ProgrammingRobotsStudyGroup/Designs-And-Notes/designs/12cm_chassis/top.pdf

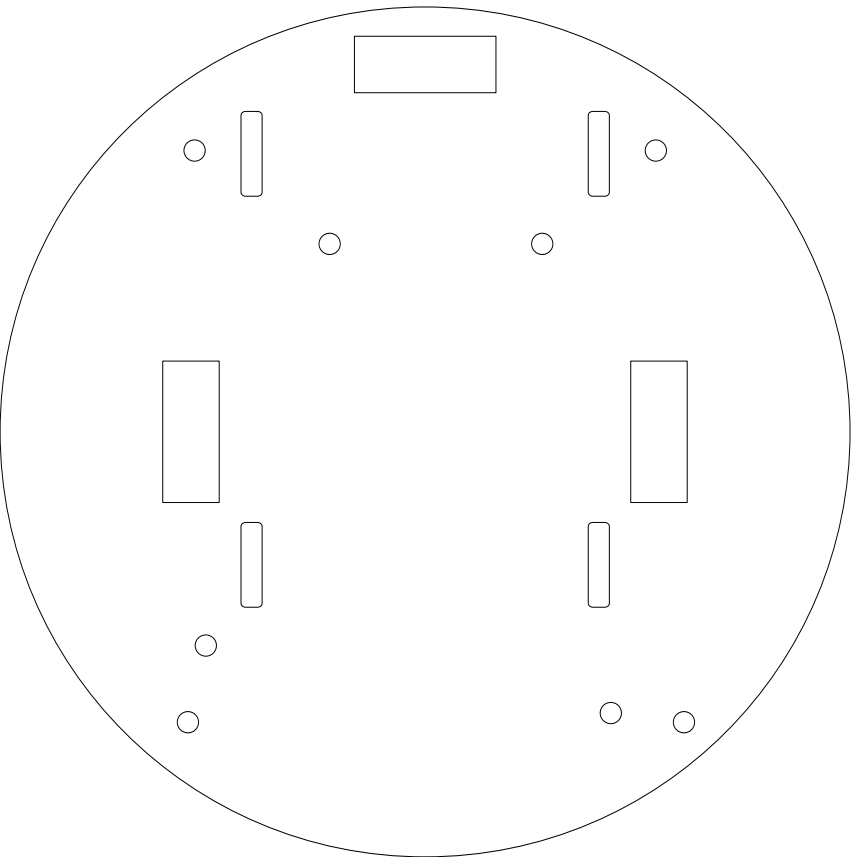
[picture p3: figure]
