ProgrammingRobotsStudyGroup/Designs-And-Notes/Data Sheets/Allegro/0J3580.1200.jpg

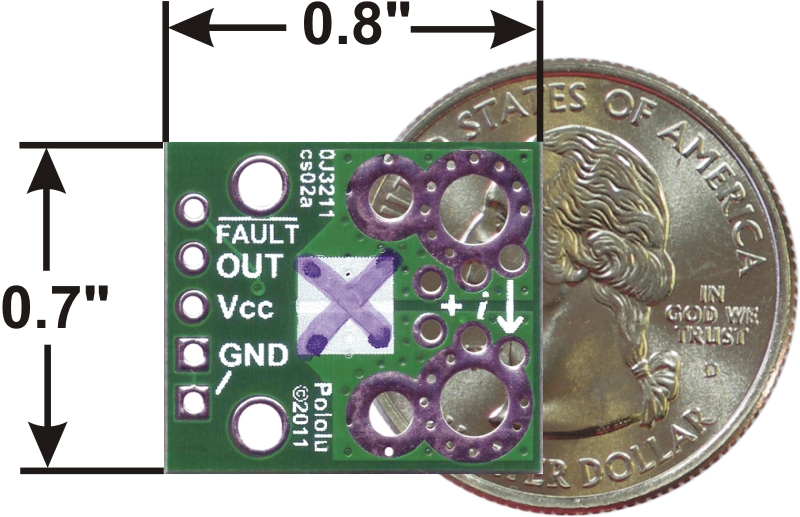
Data Sheets/Allegro/0J3580.1200.jpg
