ProgrammingRobotsStudyGroup/Designs-And-Notes/Data Sheets/Allegro/0J3586.1200.jpg

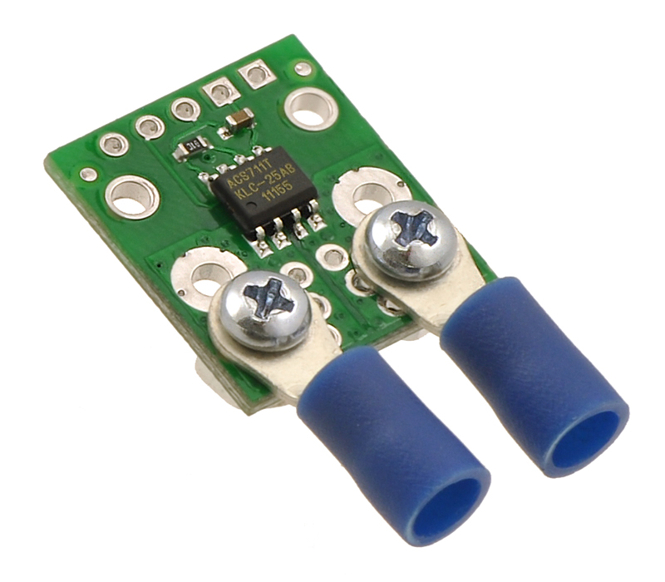
Data Sheets/Allegro/0J3586.1200.jpg
