ProgrammingRobotsStudyGroup/Designs-And-Notes/Data Sheets/Allegro/0J3588.1200.jpg

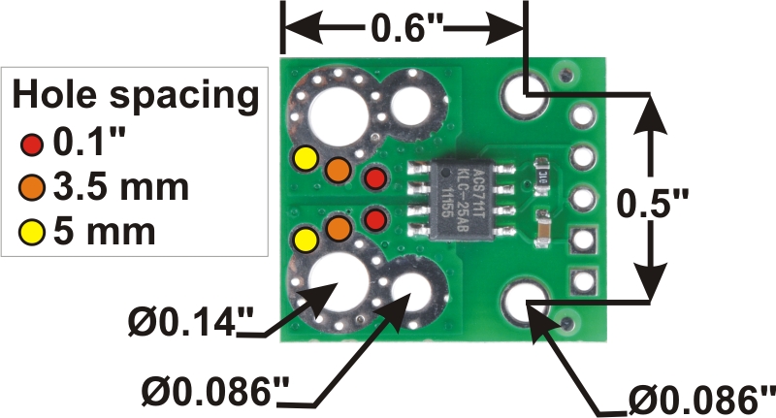
Data Sheets/Allegro/0J3588.1200.jpg
