ProgrammingRobotsStudyGroup/Designs-And-Notes/Data Sheets/Allegro/ACS711 schematic dia.png

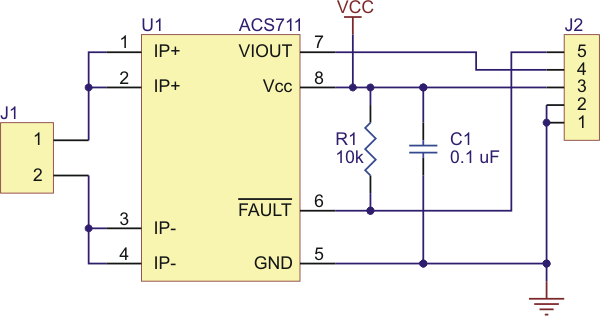
Data Sheets/Allegro/ACS711 schematic dia.png
