ProgrammingRobotsStudyGroup/Designs-And-Notes/Data Sheets/Pololu/60×8mm wheel with tire removed.jpg

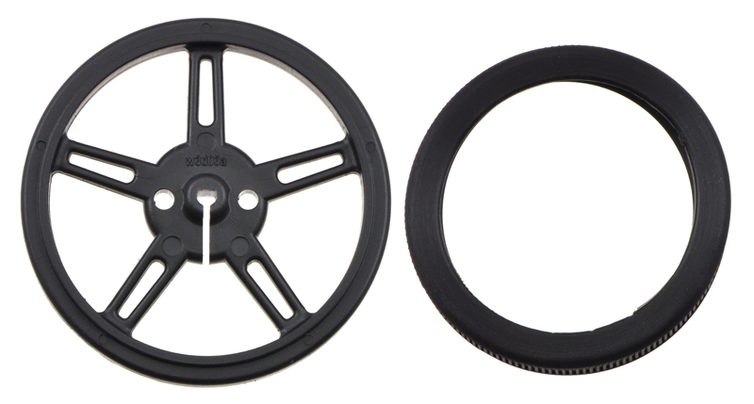
Data Sheets/Pololu/60×8mm wheel with tire removed.jpg
