ProgrammingRobotsStudyGroup/Designs-And-Notes/Data Sheets/Pololu/Mechanical drawing of Pololu wheel 60×8mm without tire..jpg

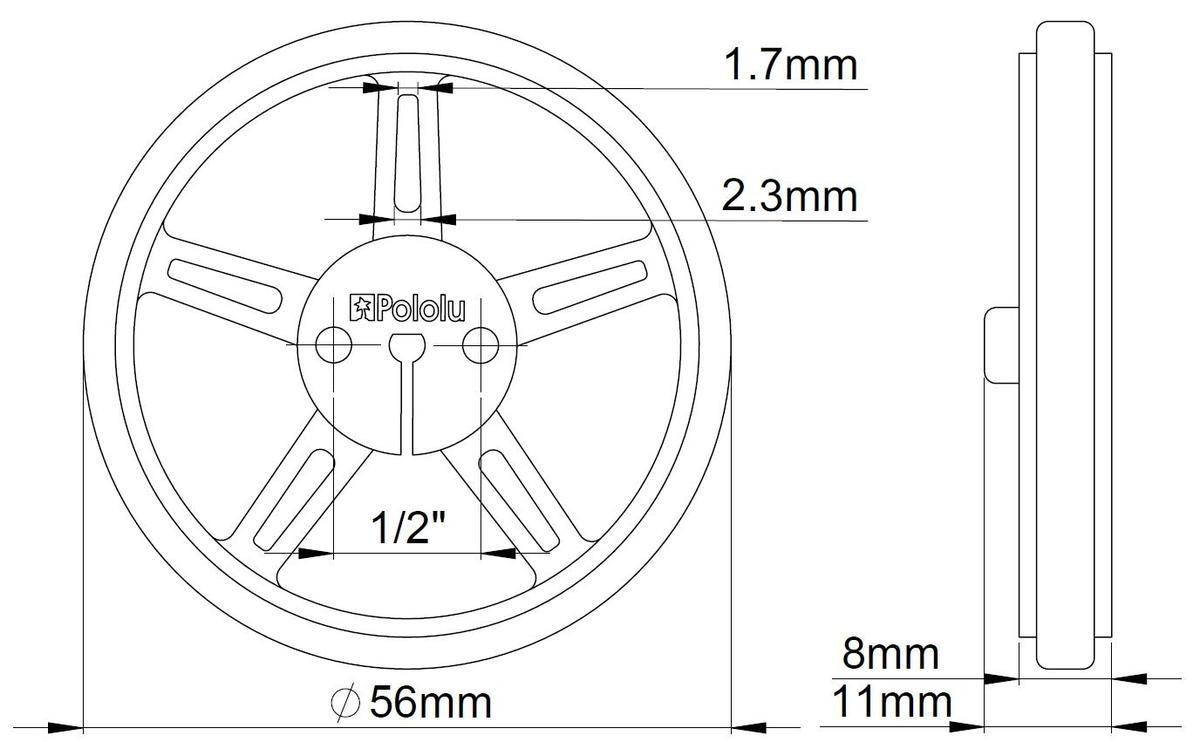
Data Sheets/Pololu/Mechanical drawing of Pololu wheel 60×8mm without tire..jpg
