ProgrammingRobotsStudyGroup/Designs-And-Notes/Data Sheets/Pololu/Pololu wheel 60×8mm – blue.jpg

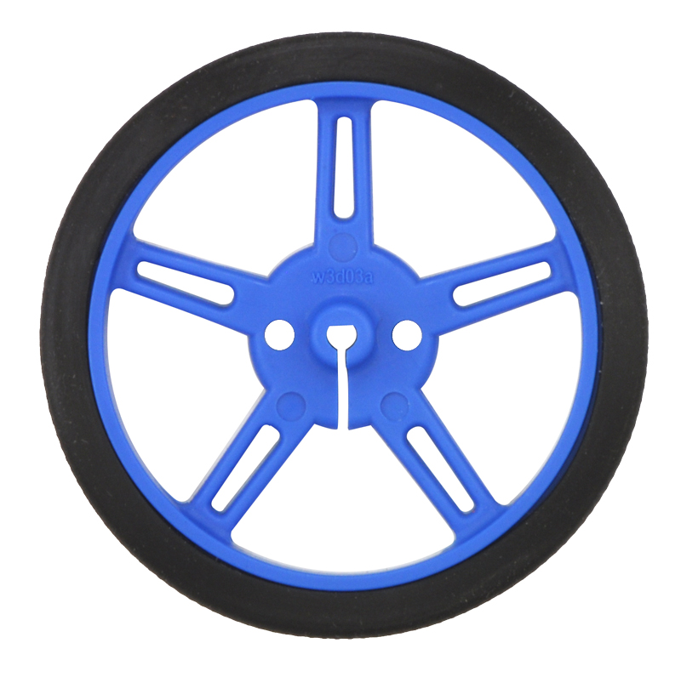
Data Sheets/Pololu/Pololu wheel 60×8mm – blue.jpg
