ProgrammingRobotsStudyGroup/Designs-And-Notes/how-to/images-assembly/a_star_bridge_pinout_dia.png

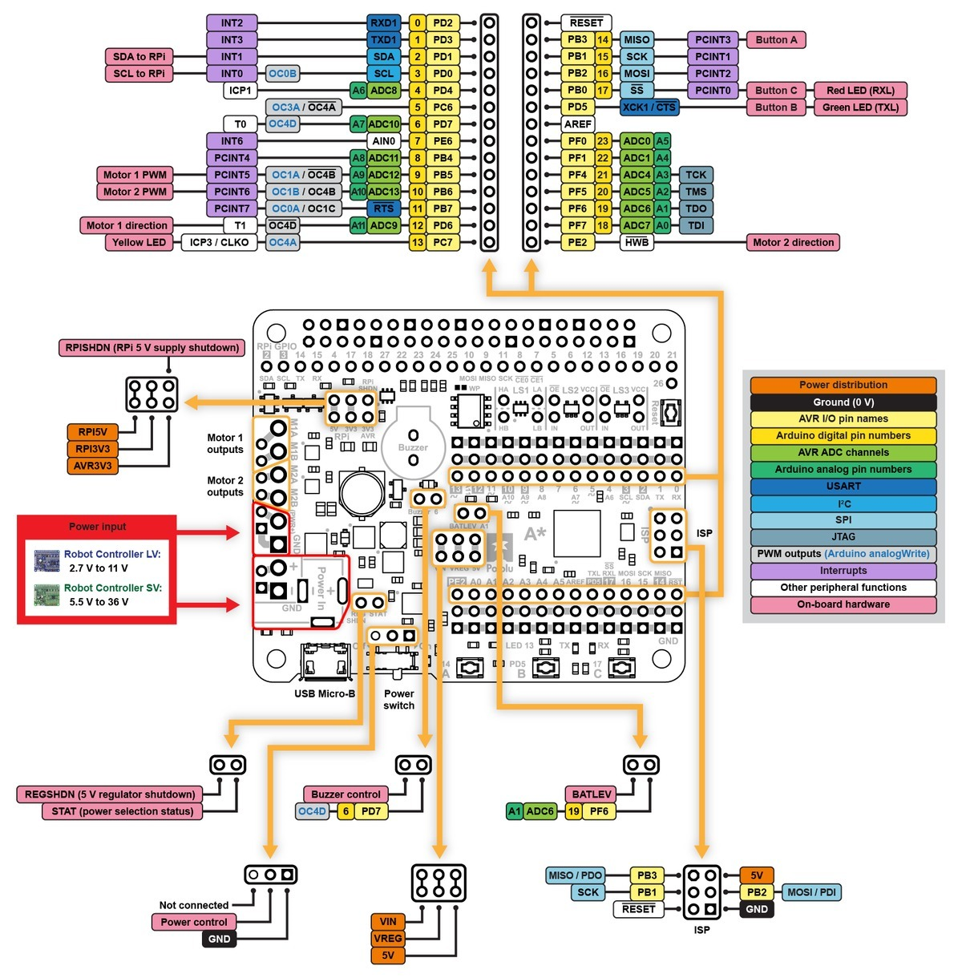
how-to/images-assembly/a_star_bridge_pinout_dia.png
