ProgrammingRobotsStudyGroup/Designs-And-Notes/images/3r2/9in base level a v13.jpg

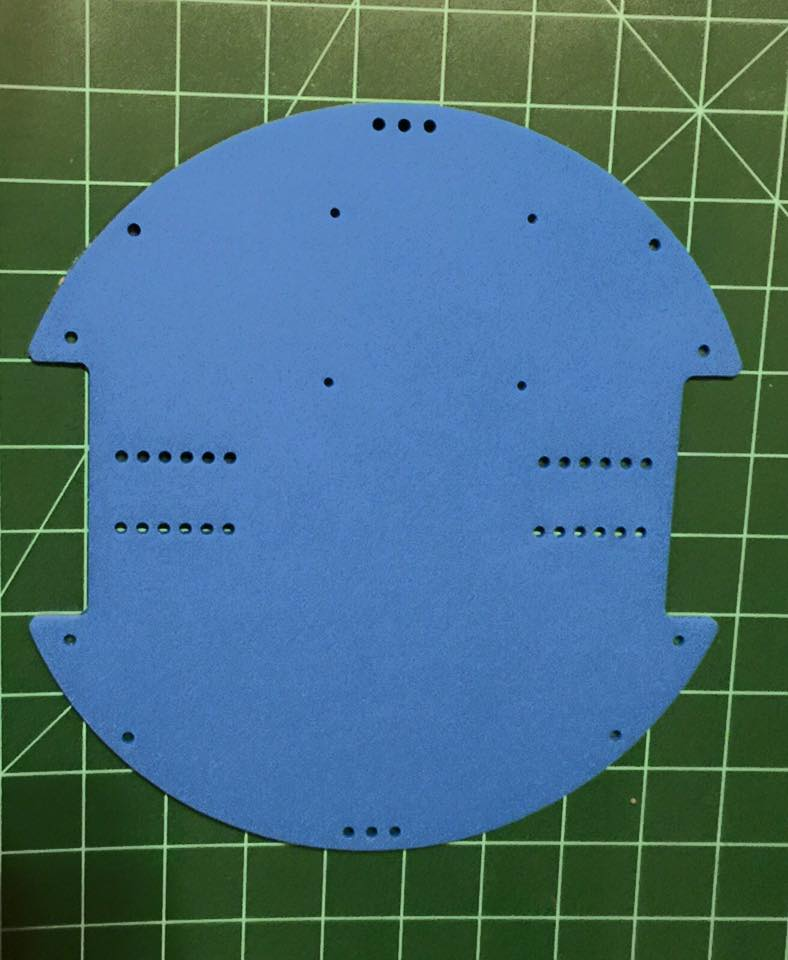
images/3r2/9in base level a v13.jpg
