ProgrammingRobotsStudyGroup/Designs-And-Notes/images/3r2/20160118_205052360_iOS.jpg

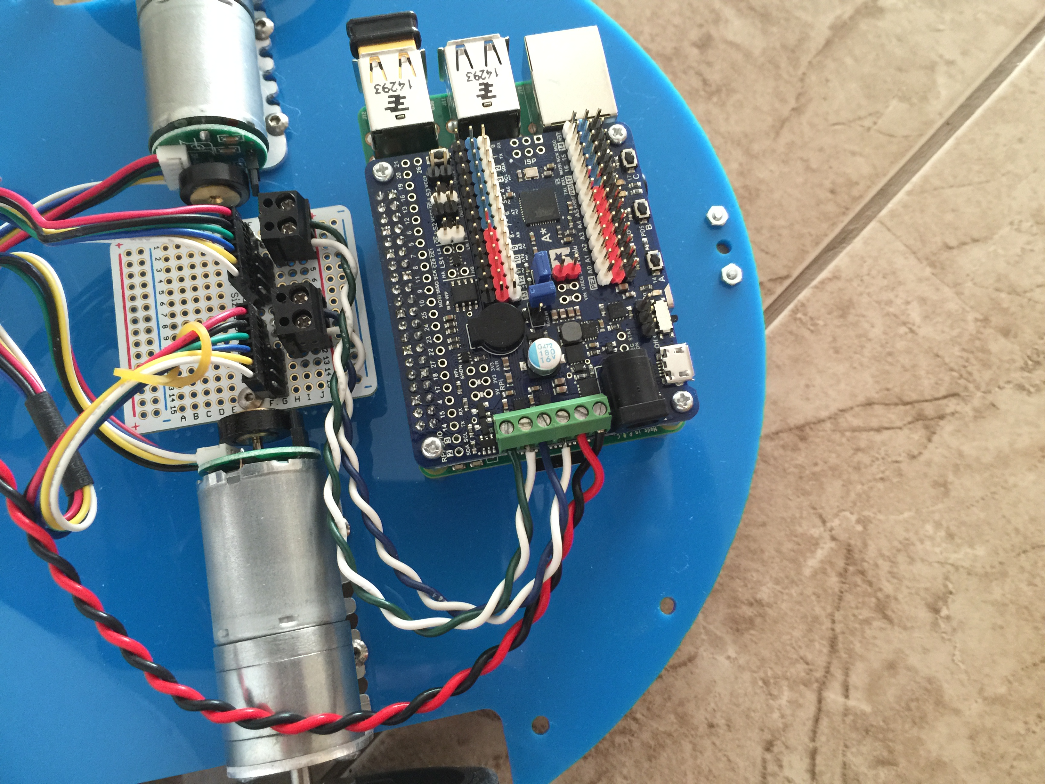
images/3r2/20160118_205052360_iOS.jpg
