ProgrammingRobotsStudyGroup/Designs-And-Notes/images/3r2/base with motor and pi plus a star.jpg

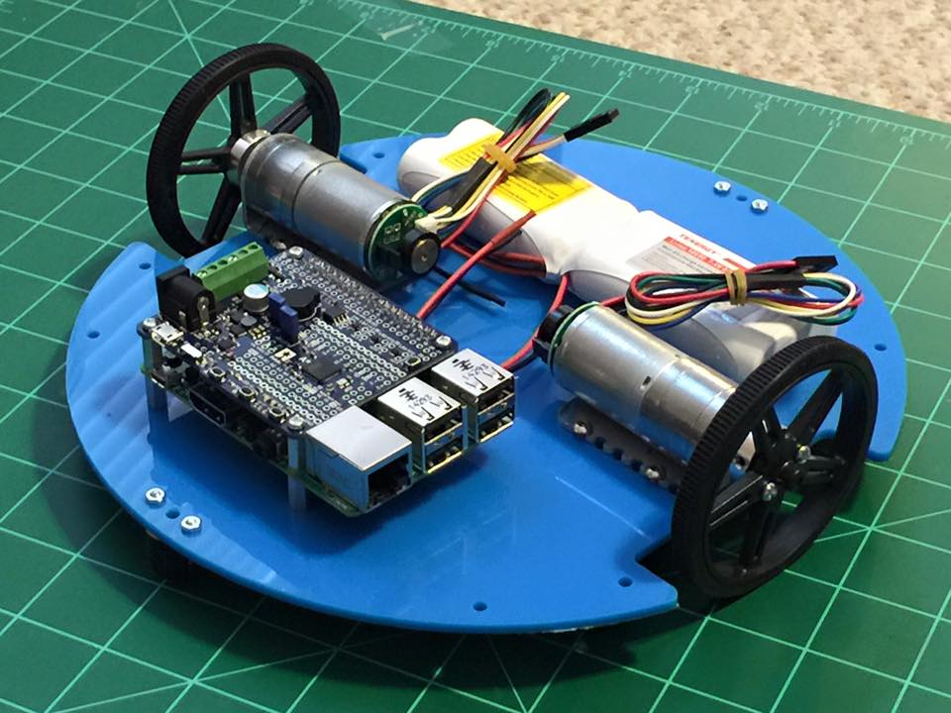
images/3r2/base with motor and pi plus a star.jpg
