ProgrammingRobotsStudyGroup/Designs-And-Notes/images/3r2/base with motors.jpg

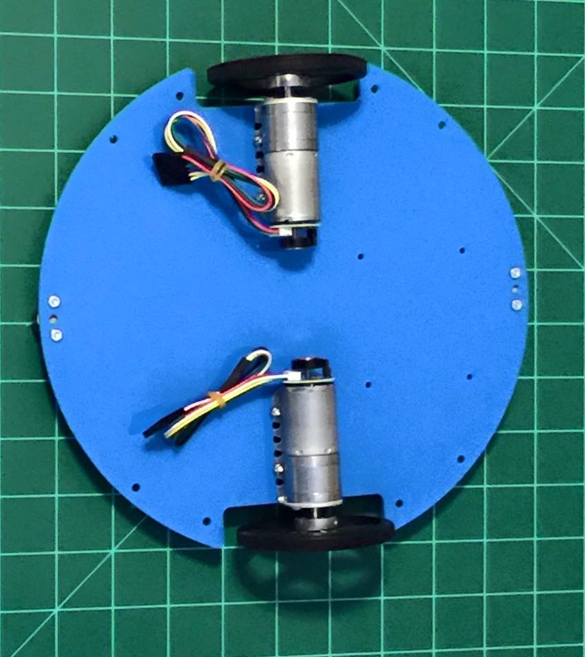
images/3r2/base with motors.jpg
