ProgrammingRobotsStudyGroup/Designs-And-Notes/images/Encoder_XOR.png

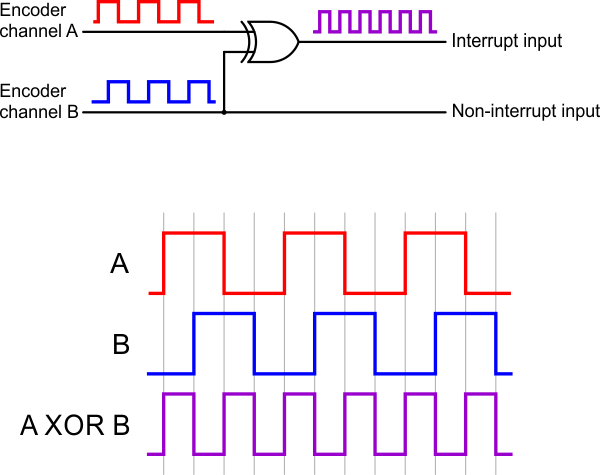
images/Encoder_XOR.png
