ProgrammingRobotsStudyGroup/Designs-And-Notes/Worksheets/pololu motor plot.png

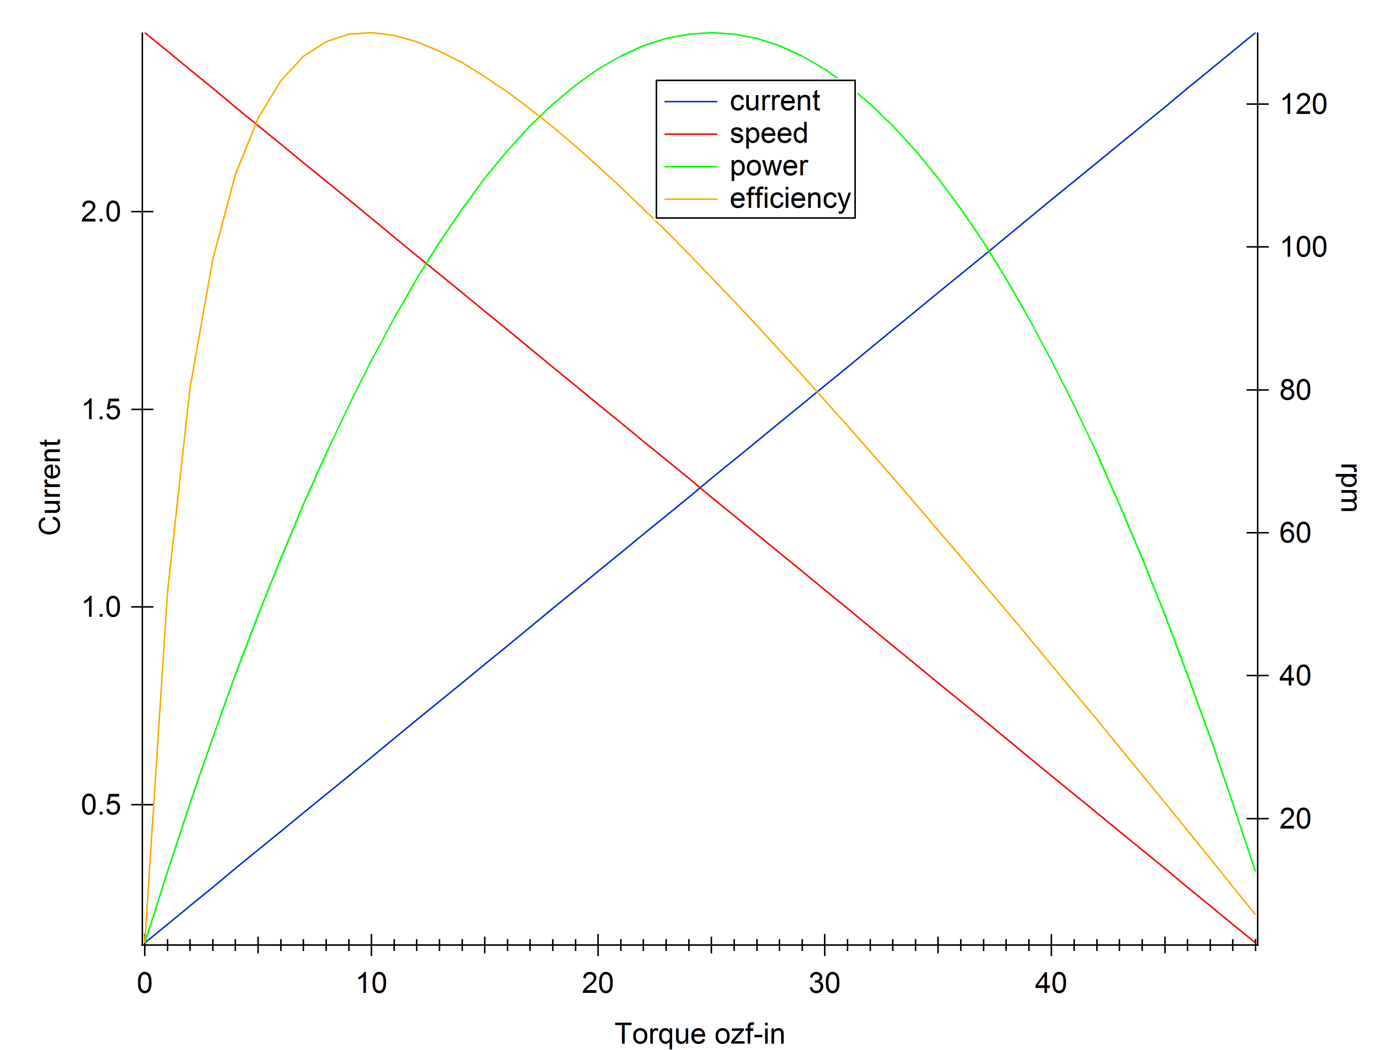
Worksheets/pololu motor plot.png
