ProgrammingRobotsStudyGroup/Designs-And-Notes/Worksheets/ROS ROV REV 2.xlsx

Sheet: Wheels
Wheel Size |  | Motor Speed |  | Motor Speed |  | Motor Speed |  | Motor Speed |  | Motor Speed |  | Motor Speed
 |  | 50 |  | 90 |  | 100 |  | 130 |  | 200 |  | 320
inches | mm | in/sec | m/sec | in/sec | m/sec | in/sec | m/sec | in/sec | m/sec | in/sec | m/sec | in/sec | m/sec
1.26 | 32 | 3.30 | 0.08 | 5.94 | 0.15 | 6.60 | 0.17 | 8.58 | 0.22 | 13.19 | 0.34 | 21.11 | 0.54
1.57 | 40 | 4.12 | 0.10 | 7.42 | 0.19 | 8.25 | 0.21 | 10.72 | 0.27 | 16.49 | 0.42 | 26.39 | 0.67
1.65 | 42 | 4.33 | 0.11 | 7.79 | 0.20 | 8.66 | 0.22 | 11.26 | 0.29 | 17.32 | 0.44 | 27.71 | 0.70
1.97 | 50 | 5.15 | 0.13 | 9.28 | 0.24 | 10.31 | 0.26 | 13.40 | 0.34 | 20.61 | 0.52 | 32.98 | 0.84
2.36 | 60 | 6.18 | 0.16 | 11.13 | 0.28 | 12.37 | 0.31 | 16.08 | 0.41 | 24.74 | 0.63 | 39.58 | 1.01
2.5 | 63.5 | 6.54 | 0.17 | 11.78 | 0.30 | 13.09 | 0.33 | 17.02 | 0.43 | 26.18 | 0.66 | 41.89 | 1.06
2.76 | 70 | 7.21 | 0.18 | 12.99 | 0.33 | 14.43 | 0.37 | 18.76 | 0.48 | 28.86 | 0.73 | 46.18 | 1.17
2.95 | 75 | 7.73 | 0.20 | 13.91 | 0.35 | 15.46 | 0.39 | 20.10 | 0.51 | 30.92 | 0.79 | 49.47 | 1.26
3.15 | 80 | 8.25 | 0.21 | 14.84 | 0.38 | 16.49 | 0.42 | 21.44 | 0.54 | 32.98 | 0.84 | 52.77 | 1.34
3.94 | 100 | 10.31 | 0.26 | 18.55 | 0.47 | 20.61 | 0.52 | 26.80 | 0.68 | 41.23 | 1.05 | 65.97 | 1.68
4.72 | 120 | 12.37 | 0.31 | 22.26 | 0.57 | 24.74 | 0.63 | 32.16 | 0.82 | 49.47 | 1.26 | 79.16 | 2.01

Sheet: Motor size sheet
 | Input
Total mass | 1.81 | Kg
Number of drive motors | 2 | #
Radius of drive wheel | 0.035 | m
Robot Velocity | 0.4 | ms
Maximum incline | 20 | deg
Supply voltage | 7.4 | V
Desired acceleration | 0.2 | m/s^2
Desired operating time | 120 | min
Total efficiency | 65 | %
 | Output
Angular Velocity | 11.43 | rad/s | 109.19 | rev/min
Torque | 0.17 | Nm | 1.77 | Kgf-cm | 24.53 | ozf-in
Total Power | 1.98 | W | 0.002655200576 | hp
Maximum current | 0.27 | A
Battery Pack | 1.07 | Ah
 | Mass(lb)
 | 1 | 2 | 3 | 4 | 5 | 10 | 20
 | Mass(Kg)
 | 0.45 | 0.91 | 1.36 | 1.81 | 2.27 | 4.54 | 9.07
Torque
Nm | 0.0434 | 0.09 | 0.13 | 0.17 | 0.22 | 0.43 | 0.87
Kgf-cm | 0.44 | 0.89 | 1.33 | 1.77 | 2.21 | 4.43 | 8.85
ozf-in | 6.15 | 12.29 | 18.44 | 24.59 | 30.74 | 61.47 | 122.95
Power
W | 0.50 | 0.99 | 1.49 | 1.98 | 2.48 | 4.96 | 9.92
A | 0.07 | 0.13 | 0.20 | 0.27 | 0.34 | 0.67 | 1.34
Ah | 0.27 | 0.54 | 0.80 | 1.07 | 1.34 | 2.68 | 5.36
 | Torque
Nm | 0.037 | 0.075 | 0.282 | 0.353 | 1.766 | 2.799 | 0.565
Kgf-cm | 0.379 | 0.760 | 2.880 | 3.600 | 17.998 | 28.532 | 5.759
ozf-in | 5.267 | 10.557 | 40.000 | 50.000 | 250.000 | 396.319 | 80.000
lbf-in |  |  |  |  |  | 24.780
Mass(Kg) | 0.3886440828 | 0.7789179634 | 2.951394937 | 3.689243671 | 18.44621835 | 29.24233301 | 5.902789873
Mass(lb) | 0.8568135368 | 1.717220163 | 6.506712043 | 8.133390054 | 40.66695027 | 64.46830886 | 13.01342409
 | Torque |  |  |  |  |  | Maker Block
Nm | 0.037 | 0.075 | 0.282 | 0.353 | 1.766 | 2.799 | 0.565
Kgf-cm | 0.379 | 0.760 | 2.880 | 3.600 | 17.998 | 28.532 | 5.759
ozf-in | 5.267 | 10.557 | 40.000 | 50.000 | 250.000 | 396.319 | 80.000
lbf-in |  |  |  |  |  | 24.780
Mass(Kg) | 0.3886440828 | 0.7789179634 | 2.951394937 | 3.689243671 | 18.44621835 | 29.24233301 | 5.902789873
Mass(lb) | 0.8568135368 | 1.717220163 | 6.506712043 | 8.133390054 | 40.66695027 | 64.46830886 | 13.01342409
Maker Block
Nm | 0.565
Kgf-cm | 5.759
ozf-in | 80.000
lbf-in
Mass(Kg) | 5.902789873
Mass(lb) | 13.01342409
Pololu
Nm | 0.353 |  | 0.177
Kgf-cm | 3.600 |  | 1.800
ozf-in | 50.000 |  | 25.000
lbf-in
Mass(Kg) | 3.689243671 |  | 1.844621835
Mass(lb) | 8.133390054 |  | 4.066695027
Mcpro
Nm | 2.799
Kgf-cm | 28.532
ozf-in | 396.319
lbf-in | 24.780
Mass(Kg) | 29.24233301
Mass(lb) | 64.46830886

Sheet: Parts List
BASE HARDWARE(MIN)
Item | QTY | Cost |  | source |  | Power V |  | Current |  | Weight
Raspberry Pi 2 | 1 | 35 | 35 |  |  | 5 | V | 0.8 | A
Wifi Adapter | 1 | 10 | 10 |  |  | 5 |  | 0.3 | A
BLE 4.0 Adapter | 1 | 10 | 10 |  |  | 5 |  | 0.001 | A
A-Star 32U4 Robot Controller LV with Raspberry Pi Bridge | 1 | 32.95 | 32.95 | Pololu | https://www.pololu.com/product/3117
Chassis Laser Cut | 1 | 0 | 0
Motors with built in wheel encoders | 2 | 34.95 | 69.9 |  | 47:1 Metal Gearmotor 25Dx52L mm LP 6V with 48 CPR Encoder (https://www.pololu.com/product/2285)
Metal Gearmotor Bracket Pair | 1 | 7.45 | 7.45 |  | 25D mm metal gearmotors (https://www.pololu.com/category/115/25d-mm-gearmotors)
Pololu Wheel 60×8mm Pair - Blue | 1 | 7.95 | 7.95 | Pololu | https://www.pololu.com/product/1423
Pololu Universal Aluminum Mounting Hub for 4mm Shaft, #4-40 Holes (2-Pack) | 1 | 6.95 | 6.95 | Pololu | https://www.pololu.com/product/1081
Pololu Ball Caster with TBD″ Plastic Ball | 2 | 1.99 | 3.98 | Pololu
Battery Power |  |  |  |  | (cost was avg from different sites)
Universal Smart Charger for Li-Ion battery Packs 3.7V - 14.8V 1-4 cells |  | 23.95 | 0 | Tenergy | http://www.tenergy.com (http://www.tenergy.com/01211?sc=59&category=38236)
7.4V 5200mAh Side By Side Li-Ion Battery Pack |  | 42.95 | 0 | Tenergy | http://www.tenergy.com (http://www.tenergy.com/31005_2)
7.4V 2200mAh Battery Pack |  | 21.95 | 0 | Tenergy | http://www.tenergy.com (http://www.tenergy.com/Tenergy-Li-Ion-18650-7-4V-2200mAh-Rechargeable-PCB-Protected-Battery-Pack)
OPT SENSOR
LINE SENSOR IDEAS
QTR-3A Reflectance Sensor Array |  | 4.95 | 0 | Pololu
QTR-1A Reflectance Sensor (2-Pack) |  | 4.25 | 0 | Pololu
QTR-8A Reflectance Sensor Array | 0 | 9.95 | 0 | Pololu
Optical Range Finders
GP2Y0A21 Sharp distance sensor (26Hz) 4″ to 32″ (10 cm to 80 cm) |  | 9.95 | 0 | Pololu
GP2Y0A41SK0F Sharp analog distance sensor (60) 1.5″ to 12″ (4 cm to 30 cm) |  | 9.95 | 0 | Pololu
GP2Y0A60SZ distance sensor(60) 4″ to 60″ (10 cm to 150 cm) | 0 | 11.95 | 0 | Pololu
Sonar Range Finders
Parallax PING))) Ultrasonic Sensor |  | 29.99 | 0
HC-SR04 Ultrasonic Distance Sensor Module |  | 2.99 | 0
IMU (Accelerometer and Gyro)
SparkFun Triple Axis Accelerometer and Gyro Breakout - MPU-6050 |  | 39.95 | 0 | SparkFun
SparkFun 9 Degrees of Freedom IMU Breakout - LSM9DS1 |  | 24.95 | 0 | SparkFun
SparkFun 6 Degrees of Freedom Breakout - LSM6DS3 |  | 19.95 | 0 | SparkFun
MPU-6050 3 Axis gyroscope + accelerometer module |  | 4.29 | 0
 |  |  | 0
 |  |  | 0
 |  |  | 0
 |  |  | 0
 |  |  | 0
 |  |  | 0
 |  |  | 0
 |  |  | 184.18

Sheet: Sheet1
Wheel Size
inches | mm
1.26 | 32 | 0.63 | 16 | -0.06 | -1.5
1.57 | 40 | 0.79 | 20 | 0.10 | 2.5
1.65 | 42 | 0.83 | 21 | 0.14 | 3.5
1.97 | 50 | 0.98 | 25 | 0.30 | 7.5
2.36 | 60 | 1.18 | 30 | 0.49 | 12.5
2.5 | 63.5 | 1.25 | 31.75 | 0.56 | 14.25
2.76 | 70 | 1.38 | 35 | 0.69 | 17.5
2.95 | 75 | 1.48 | 37.5 | 0.79 | 20
3.15 | 80 | 1.57 | 40 | 0.89 | 22.5
3.94 | 100 | 1.97 | 50 | 1.28 | 32.5
4.72 | 120 | 2.36 | 60 | 1.67 | 42.5
0.12 | 3
0.57 | 14.5
 | 17.5
