ProgrammingRobotsStudyGroup/Designs-And-Notes/Data Sheets/Sharp/sds02a-with-sensor.step

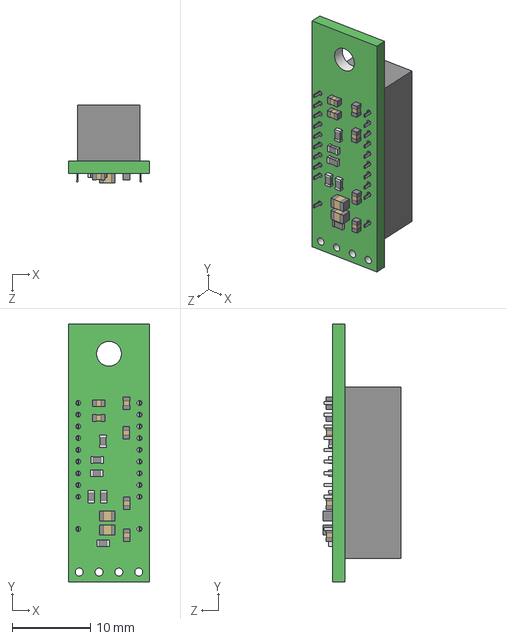
[picture p18: CAD file, 2016-01-05]
Data Sheets/Sharp/sds02a-with-sensor.step
10.4 x 33.0 x 10.0 mm
