ProgrammingRobotsStudyGroup/Designs-And-Notes/designs/camera_mount/raspberri_pi_camera_case_front_v0.4.2.STL

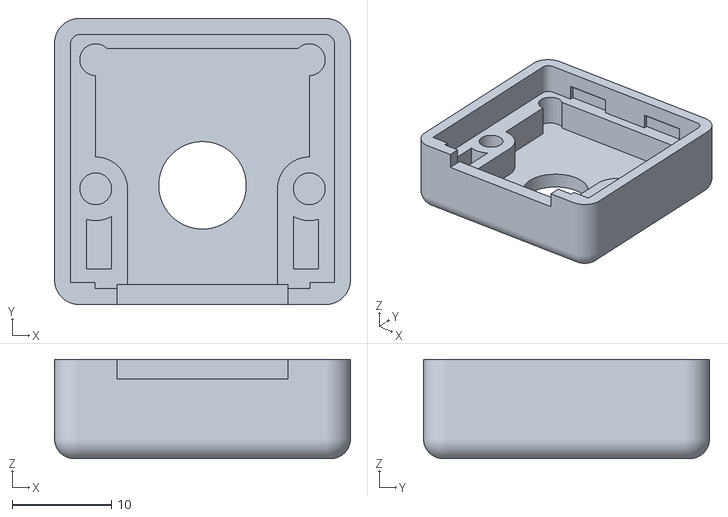
[picture p19: CAD file, 2016-05-28]
designs/camera_mount/raspberri_pi_camera_case_front_v0.4.2.STL
29.8 x 28.8 x 10.0
