ProgrammingRobotsStudyGroup/Designs-And-Notes/designs/ir_bracket/bracket1.fcstd

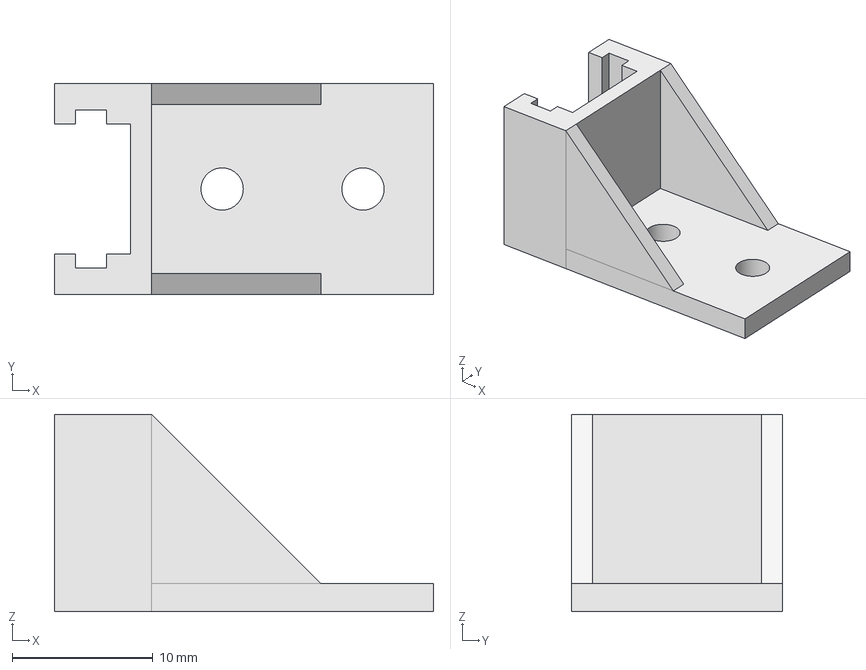
[picture p20: CAD file, 2015-12-29]
designs/ir_bracket/bracket1.fcstd
26.9 x 15.0 x 14.0 mm
