ProgrammingRobotsStudyGroup/Designs-And-Notes/designs/camera_mount/raspberri_pi_camera_case_back_v0.4.STL

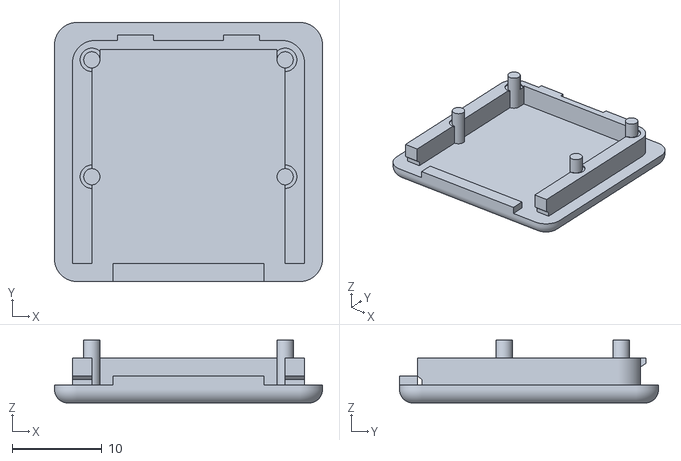
[picture p21: CAD file, 2016-05-28]
designs/camera_mount/raspberri_pi_camera_case_back_v0.4.STL
29.8 x 28.8 x 7.00
