ProgrammingRobotsStudyGroup/Designs-And-Notes/designs/ir_bracket/pololu-ir-mount.stl

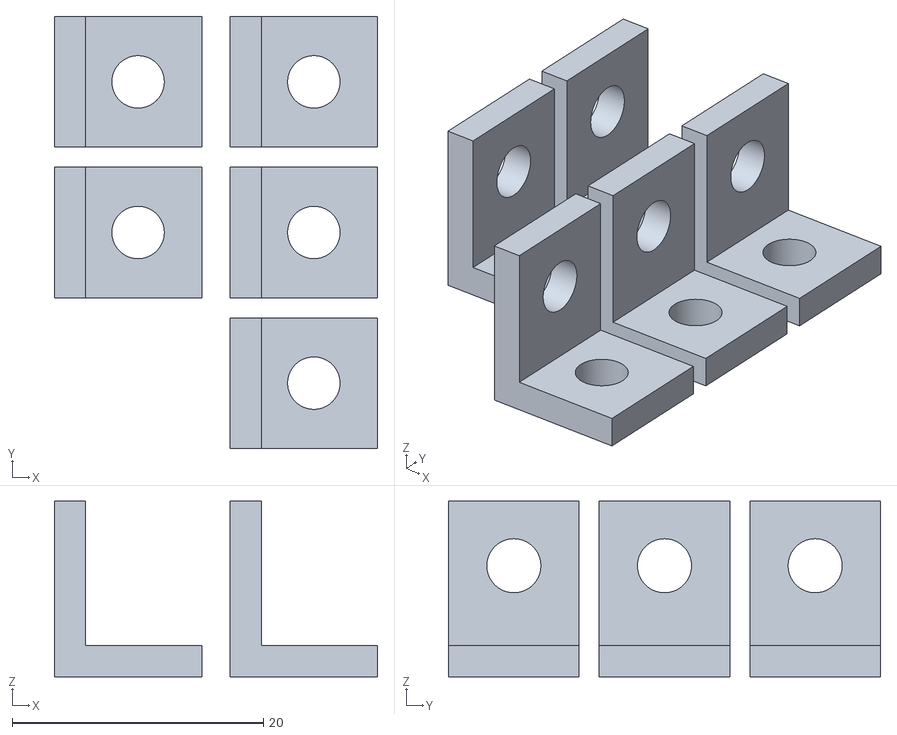
[picture p22: CAD file, 2015-12-07]
designs/ir_bracket/pololu-ir-mount.stl
25.8 x 34.4 x 14.0
