ProgrammingRobotsStudyGroup/Designs-And-Notes/(list of files, cad)

Other CAD files:
designs/20cm_chassis/20cm_base.fcstd
designs/ir_bracket/bracket1.stl
