ProgrammingRobotsStudyGroup/Designs-And-Notes/how-to/navigation.asciidoc

= Running the Navigation Stack

== Installing Dependencies

----
sudo apt-get install ros-indigo-move-base
sudo apt-get install ros-indigo-map-server
curl -ssL http://get.gazebosim.org | sh
----
