ProgrammingRobotsStudyGroup/Designs-And-Notes/how-to/images-assembly/1IRSensor.jpg

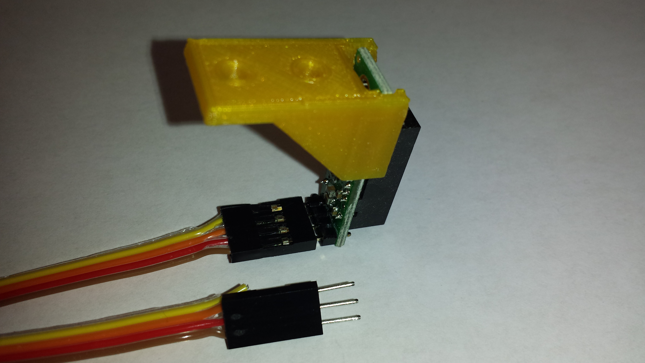
how-to/images-assembly/1IRSensor.jpg
