ProgrammingRobotsStudyGroup/Designs-And-Notes/how-to/images-assembly/6IRSensorsPlusPi.jpg

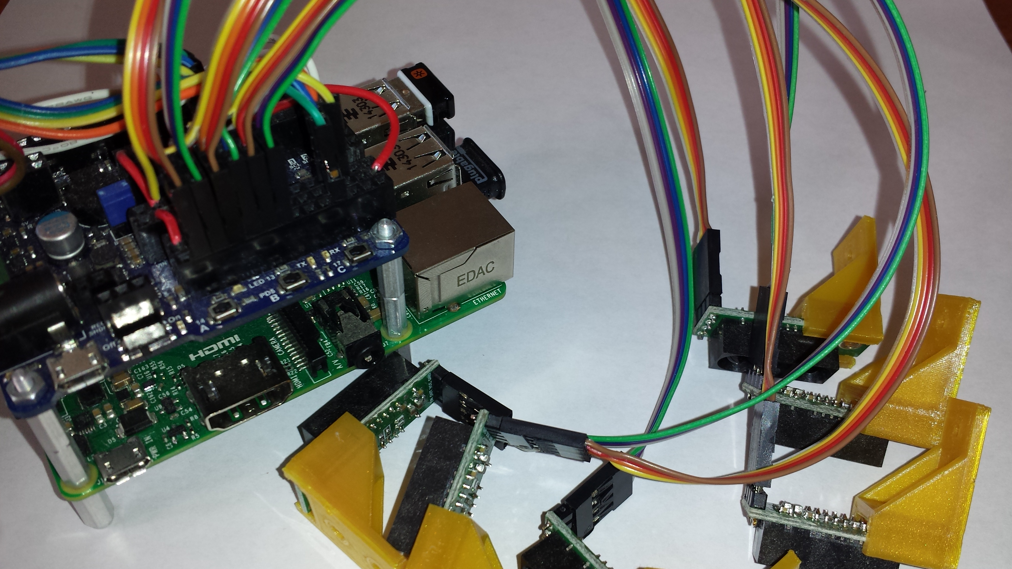
how-to/images-assembly/6IRSensorsPlusPi.jpg
