ProgrammingRobotsStudyGroup/Designs-And-Notes/how-to/images/750px-Adapter_dvi_hdmi_S7302224_wp.jpg

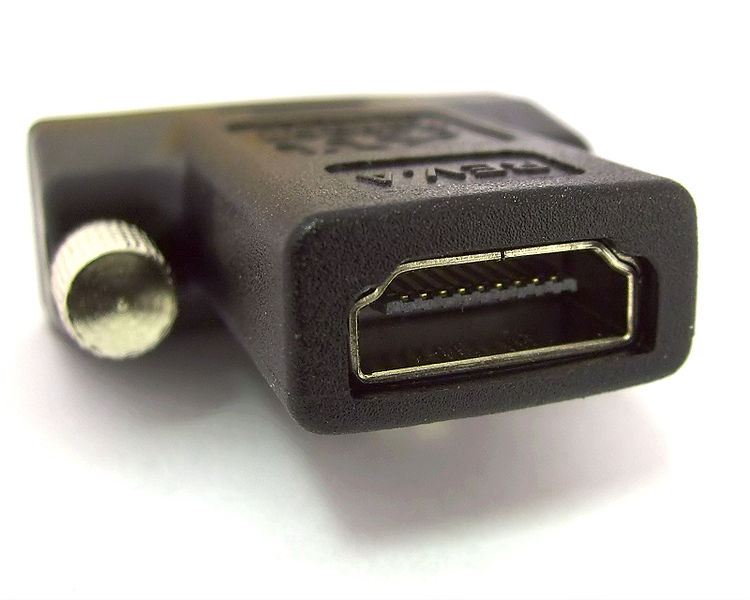
how-to/images/750px-Adapter_dvi_hdmi_S7302224_wp.jpg
