ProgrammingRobotsStudyGroup/Designs-And-Notes/how-to/images/800px-Composite-video-cable.jpg

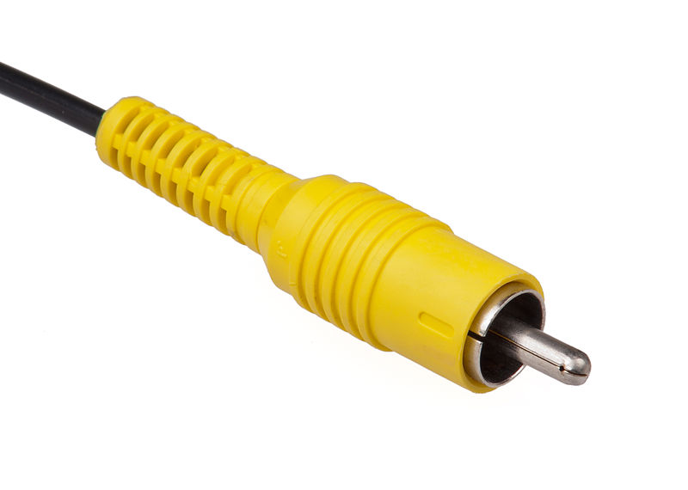
how-to/images/800px-Composite-video-cable.jpg
