ProgrammingRobotsStudyGroup/Designs-And-Notes/how-to/images/800px-HDMI.jpg

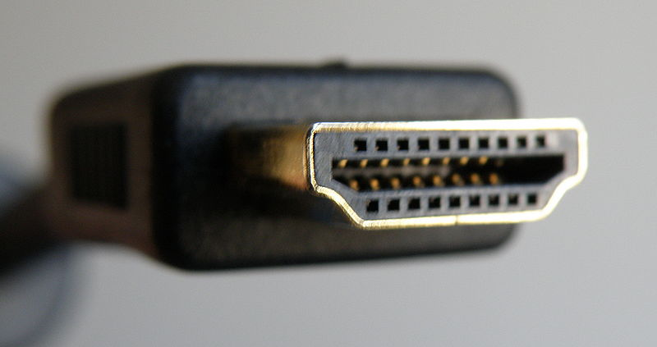
how-to/images/800px-HDMI.jpg
