ProgrammingRobotsStudyGroup/Designs-And-Notes/designs/9in_3Rsquared/level a v 13.pdf

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

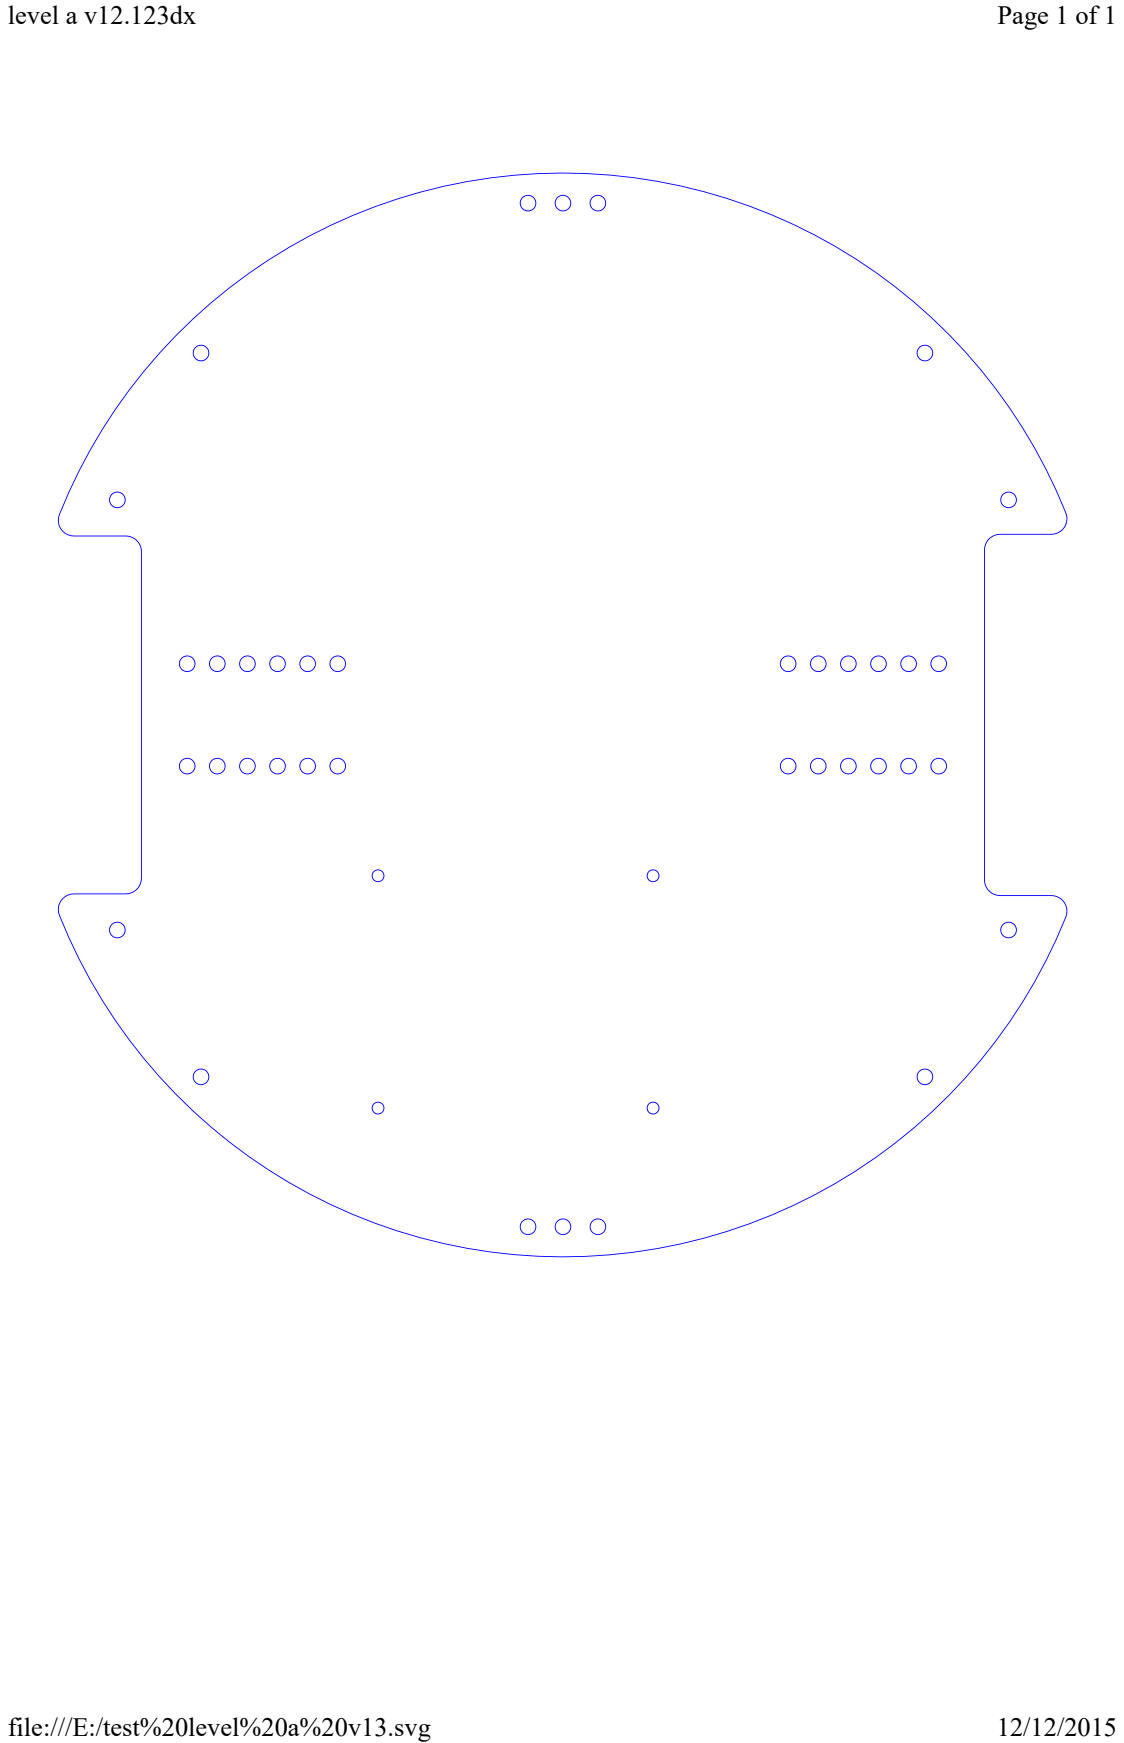
[picture p33: page 1]
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
