ProgrammingRobotsStudyGroup/Designs-And-Notes/designs/12cm_chassis/base.pdf

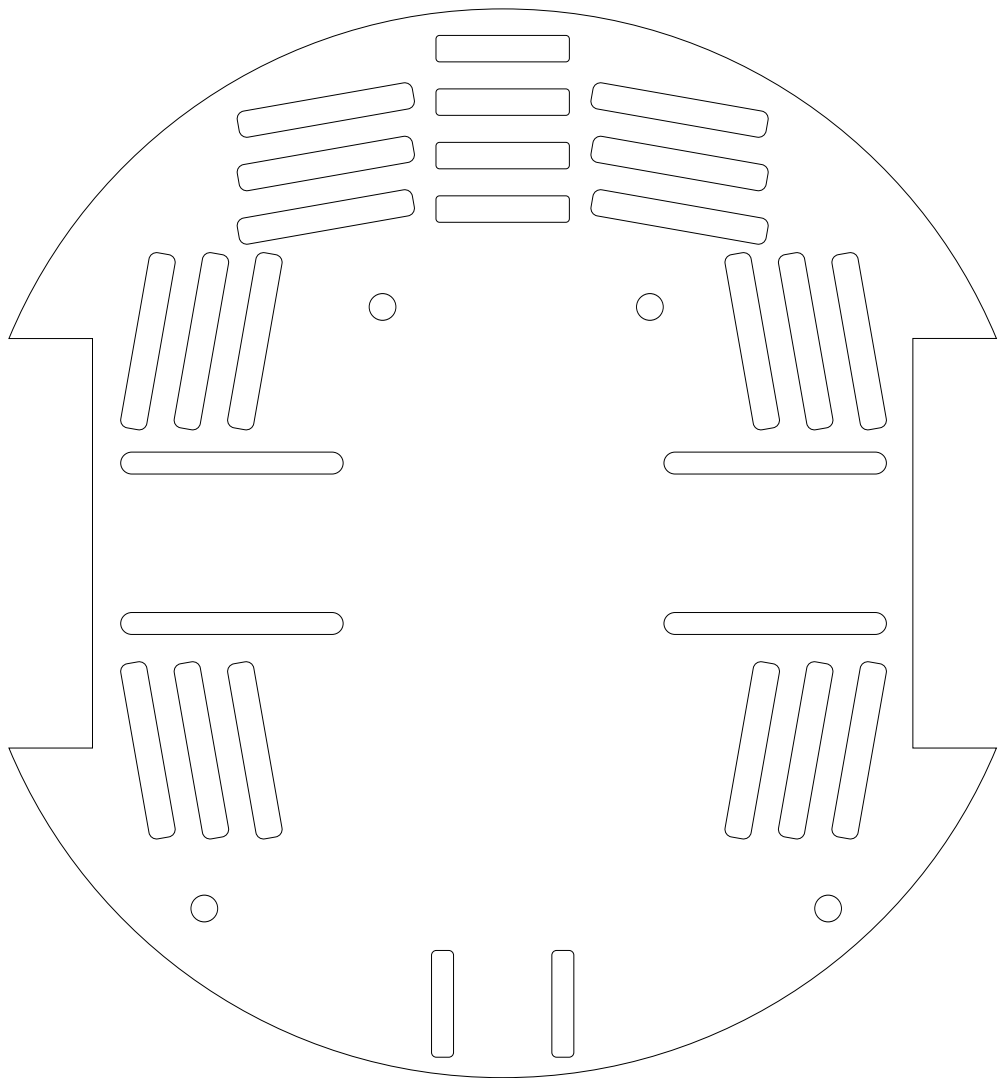
[picture p34: page 1]
