ProgrammingRobotsStudyGroup/Designs-And-Notes/(commit log)

2015-09-15 Add wheel info
    just some info on the wheels the are current the one I looking at
2015-09-15 excel work sheet
    [ROS ROV REV 2.xlsx]
2015-09-15 Create Motor Sizing.txt
2015-09-15 Added datasheet of the Digilent motor. Part #290-006P / 290-008P
2015-09-15 this is the real data sheet for the motor
2015-09-15 updated info
    [ROS ROV REV 2.xlsx]
2015-09-30 motor calc updated
    [ROS ROV REV 2.xlsx]
2015-09-30 compare motors
    [ROS ROV REV 2.xlsx]
2015-10-02 updated part list
    [ROS ROV REV 2.xlsx]
2015-10-09 Add Data sheets
    Data sheet for the A Star 32U4 Robot Controller LV with Raspberry Pi
    Bridge
2015-10-23 adding motor plot
    [ROS ROV REV 2.xlsx]
2015-10-26 Motor plots
    worksheet to make plots with
    [Motor Plots.xlsx]
2015-10-26 fix slope math error
    error is t_m math fixed
    [Motor Plots.xlsx]
2015-10-26 clean up
    [Motor Plots.xlsx]
2015-10-27 layout change
    [Motor Plots rev2.xlsx]
2015-11-13 bom work
    work on parts list for black friday buy
    [PRSG BOM.xlsx, ROS ROV REV 2.xlsx]
2015-11-23 Added Raspberry Pi ROS image setup information.
2015-11-24 Create draft list of pin assignments
    Initial proposal - needs refinement and discussion
2015-12-02 Added more info about the shutdown switch.
2015-12-06 Added some robot base designs.
    [robot-base.scad]
2015-12-06 Added IR sensor mount design.
    [pololu-ir-mount.scad]
2015-12-06 Refined the mount design, and added an STL version.
    [pololu-ir-mount.scad, pololu-ir-mount.stl]
2015-12-08 20cm chassis design. Thanks Marco!
    [20cm_base.fcstd]
2015-12-08 Cleaned up version of the chassis. Simpler constraints.
    [20cm_base.fcstd]
2015-12-29 Add documents which describe a 3D printable bracket.
    [bracket1.fcstd, bracket1.stl]
2016-01-02 Add the first 2 steps of fabrication and assembly.
2016-01-04 Added 5V regulator datasheet.
2016-01-04 Moved designs into subdirectories per request from Fred.
    [pololu-ir-mount.scad, pololu-ir-mount.stl, robot-base.scad]
2016-01-04 Added the Micro-mouse 12cm robot design.
    [micro-mouse.scad]
2016-01-04 Added more parts info for the 12cm design.
2016-01-05 Added more data sheets
    added data sheet for sensor and a few orther ideam that people may be
    using
    [sds02a-with-sensor.step]
2016-01-09 3R^2 design
    This is my laser cutter file for my design 3R^2. it base on a 9in.
2016-02-19 Clarify how to get A-Star 32u4 Arduino Dev area running.
2016-02-21 ROS Serial changes
    Move wiring to the RPi Serial section.
    Add wire to jumper.
    Add renaming machine section.
    Add section for USB, I2C and Serial Comm from A-Star to Pi
2016-02-22 Wiring image of 32u4 power.
2016-02-23 Multiple updates.
    - Picture of bus power wiring.
    - Update USB section.
    - ros.h mod
    - 2 Alternate Arduino RosSerial builds.
    - Pi Code
    - Shutdown Switch
2016-02-23 Pin headers, USB cable and Serial Comm pic.
    Fix pin headers.
    Add Serial Comm wiring pic.
    Add Short USB cable reference.
2016-03-06 yea fat fingers
2016-03-13 Move images and doc from assembly to how-to
2016-04-17 Update PiToWAP.adoc
    Added section for network address translation (seemed necessary for me to get it to work). Also a couple minor changes and added one reference.
2016-05-28 Added a Raspberry Pi camera mount.
    [pi-cam-mount-composite.scad, raspberri_pi_camera_case_back_v0.4.STL, raspberri_pi_camera_case_front_v0.4.2.STL]
2016-05-29 Fixed a problem where one part had a base lower than Z=0. Increased the size of ventilation holes in the camera case back.
    [pi-cam-mount-composite.scad]
2016-06-13 1st cut at planner
2016-07-18 Added info about pin usage on Marco's and Mark's robots.
2016-07-18 Added wiring information for the UART.
2016-07-18 Minor additions to the pin assignments
2016-07-18 Clarified instructions on custom encoder pins.
    Added information on enabling the EnableInterrupt library if you are using pins that don't support hardware interrupts.
    Also added more information about reading the battery voltage.
2016-07-18 Added Fred's image showing UART wiring.
2016-07-19 Clarified I2C tradeoffs.
2016-07-19 Added more details about custom pin selection.
2016-07-19 Clarified how the sensorstate_rate parameter works.
2016-07-20 Added a teaser about sensor frames, coming soon.
2016-07-20 Added STL for the camera mount.
2016-07-25 Added a URDF file for a 9-inch robot with 5 IR sensors and a Pi camera.
    [prsg2_description.urdf]
2016-07-27 Added .xacro version of the robot configuration. The .xacro definition makes it easier to add more IR sensors by defining a macro for placing an IR sensor at a desired angular position around the per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
    [prsg2_description.xacro]
2016-10-25 Add data sheets for PING sensor and RTC
2016-11-10 2 new IR sensor images
2018-02-05 Added info about FacetimeHD camera drivers
2018-04-20 Fix an error in setup for Marco's pin arrangement
2018-04-20 Add info on Raspberry Pi 3 UART setup
    Added information about how to use the hardware UART on the Raspberry Pi 3 (by
    disabling Bluetooth, unfortunately).
